ciqian136/smart_home/smart_home.ioc

Mcu.UserName=STM32F103ZETx
PA1.Signal=ADCx_IN1
PA10.Signal=USART1_RX
PA13.Signal=SYS_JTMS-SWDIO
PA14.Signal=SYS_JTCK-SWCLK
PA2.Signal=USART2_TX
PA3.Signal=USART2_RX
PA4.Signal=ADCx_IN4
PA6.Signal=GPIO_Output
PA7.Signal=GPIO_Output
PA9.Signal=USART1_TX
PB10.Signal=USART3_TX
PB11.Signal=USART3_RX
PB5.Signal=GPIO_Output
PB6.Signal=I2C1_SCL
PB7.Signal=I2C1_SDA
PC10.Signal=UART4_TX
PC11.Signal=UART4_RX
PC12.Signal=UART5_TX
PC2.Signal=GPIO_Input
PD12.Signal=S_TIM4_CH1
PD13.Signal=S_TIM4_CH2
PD15.Signal=S_TIM4_CH4
PD2.Signal=UART5_RX
PE5.Signal=GPIO_Output
