ciqian136/smart_home/APP/headfile.h

#ifndef __HEADFILE_H__
#define __HEADFILE_H__

/*系统头文件*/
#include <stdio.h>
#include <string.h>
#include <stdlib.h>
#include <stdarg.h>
#include <stdint.h>

#include <main.h>
#include <gpio.h>
#include <usart.h>
#include <dma.h>
#include <adc.h>
#include <time.h>
#include <i2c.h>

/*用户头文件*/
#include "schedule.h"
#include "json_parser.h"
#include "esp32.h"
#include "my_uart.h"
#include "smoke.h"
#include "my_adc.h"
#include "board_led.h"
#include "status_led.h"
#include "PM25.h"
#include "BH1750.h"
#include "voice.h"
#include "face.h"
#include "lcd.h"
#include "dht11.h"
#include "fan.h"
#include "ws2812.h"
#include "ws2812_2.h"

#endif
