ciqian136/smart_home/(commit log)

2026-06-28 添加语音和一些初始化
2026-06-28 DHT11完成
2026-06-28 添加风扇 改变pwm范围为1000
2026-07-06 完成lcd和风速模块
2026-09-03 Refactor sensor drivers and timing logic
2026-09-03 Refactor UART and sensor voice handling
2026-09-05 Refactor sensors UART and voice integrations
2026-09-05 Fix hardware notes and document UART protocols
2026-10-06 Add Xiaozhi remote control link (home/cmd downlink)
    把 smart_home 接到小智（xiaozhi-esp32）那条 MQTT 链路上，打通下行控制：
    STM32 周期性发布 home/state，小智通过 home/cmd 下发控制指令。端到端契约见
    project_docs/小智对接.md。
    - home_cmd.*：新增。解析并执行 home/cmd（LED / 风扇 / 两路灯带 / op=query），
    字段全部可选、数值钳位，兼容 OneNET 旧字段名与 {"value":X} 包装写法。
    - esp32_xiaozhi.*：新增 MQTT 后端。初始化状态机 ATE/RST/CWMODE/CWJAP/
    MQTTCLEAN/MQTTUSERCFG/MQTTCONN/MQTTSUB/CIPSNTPCFG，周期上报 home/state
    并订阅 home/cmd；AT+MQTTPUBRAW 的 OK + ">" 分两次收上来的时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
2026-10-06 Sync project docs into the repo and add the Xiaozhi integration contract
    project_docs/ 一直放在工作区根目录（在仓库之外），仓库里的 README.md 和 docs/
    还是旧版本，上一版提交里指向 project_docs/ 的引用在 GitHub 上是断的。
    这次把工程目录里的最新文档同步回仓库的既有位置，仓库成为唯一权威来源。
    - README.md、docs/{通信,问题,硬件,函数}.md：用最新版本覆盖
    （补上 home/cmd 下行契约、PB5 状态灯排查表、环境告警阈值与边沿触发说明等）
    - 新增 docs/小智对接.md：两端对接契约、STM32/小智实现说明、联调步骤、
    13 项验证清单、已知限制
    - 新增 do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
